wekospace/weko/documentation/paliers/SBRxxUU.jpg

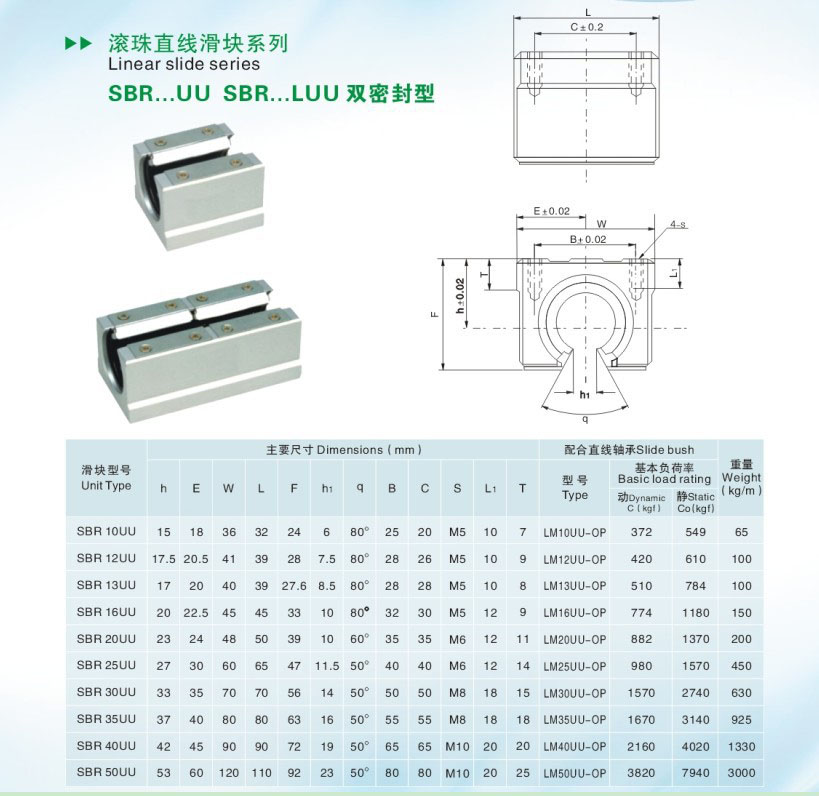
documentation/paliers/SBRxxUU.jpg
