wekospace/weko/documentation/moteurs/AluCNC - moteur Y - 57BYGH76-401A.jpg

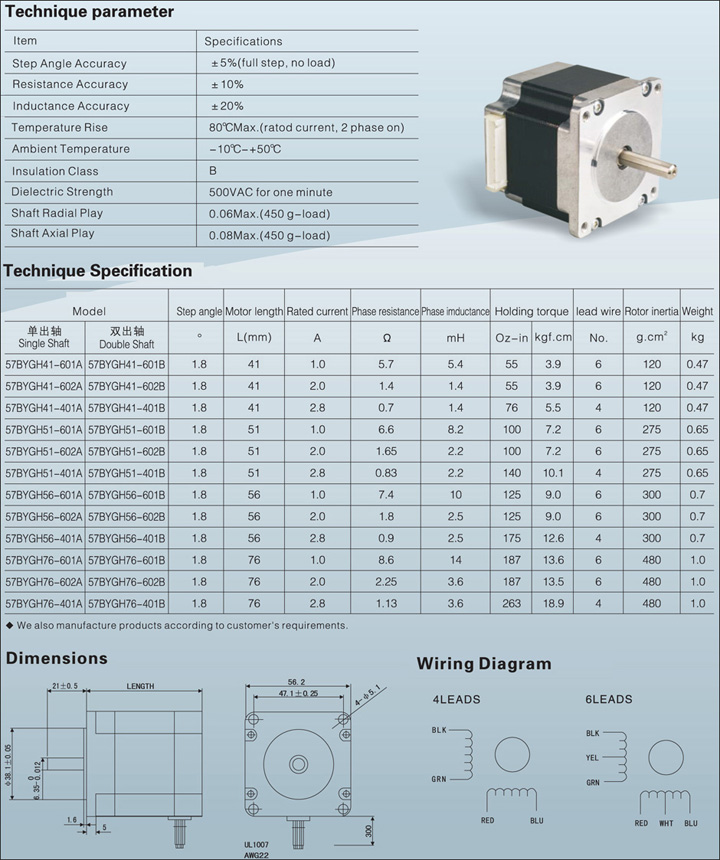
documentation/moteurs/AluCNC - moteur Y - 57BYGH76-401A.jpg
