wekospace/weko/documentation/paliers/SHFxx.jpg

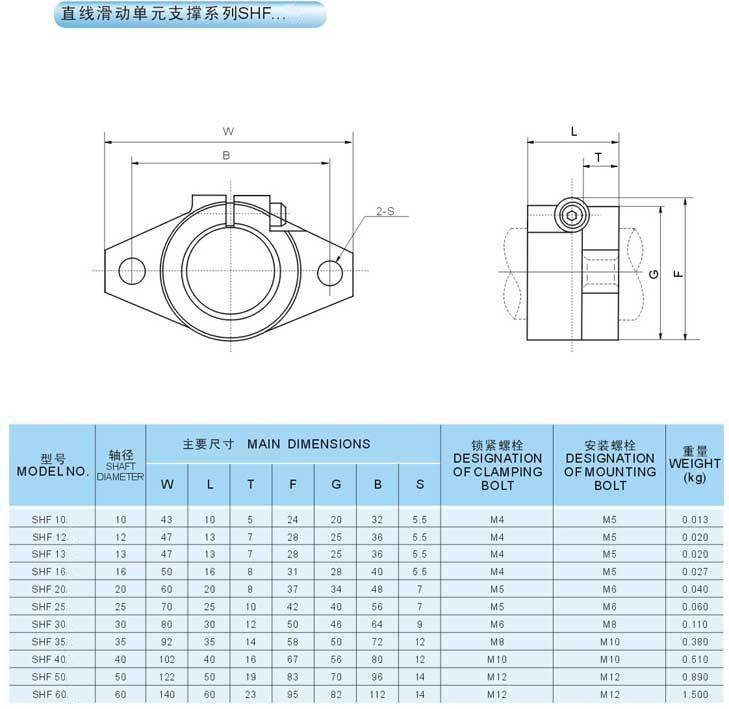
documentation/paliers/SHFxx.jpg
