wekospace/weko/Nomenclature.xls

N° | QTE | DESCRIPTION | OBSERVATION | DISTRIBUTEUR | CODE CDE DISTRIBUTEUR | UDV | QTE d'UDV | PRIX d'UDV HT | PRIX d'UDV TTC | PRIX HT | PRIX TTC | DISPONIBILITEE | TOTAL | ETAT | EMETTEUR | CEDRIC | CARLOS | ROMUALD
1 | 4 | Soutenu ferroviaire TBS20, 1000mm |  | MOTEDIS |  | 1 | 4 | 36.13 | 43.356 | 144.52 | 173.424 |  |  | reçu | CEDRIC | 395.4908
2 | 2 | Arbre de précision 20mm h6,trempé et rectifié, 400mm |  | MOTEDIS |  | 1 | 2 | 6.72 | 8.064 | 13.44 | 16.128
3 | 4 | Palier + douille a bille |  | MOTEDIS | SCE20UU | 1 | 4 | 7.48 | 8.976 | 29.92 | 35.904
4 | 4 | Support arbre Aluminium anodis | SH20 | MOTEDIS | SH20 | 1 | 4 | 3.53 | 4.236 | 14.12 | 16.944
5 | 2 | Profilé aluminium 45x90lourd B-Typ rainure 10 | 45x90lour x 1040mm, 4 x usinage M12 | MOTEDIS | 45x90lourd B-Typ | 1 | 2 | 27.32 | 32.784 | 54.64 | 65.568
6 | 2 | Profilé aluminium 40x80 B-Typ rainure 10 | 40x80 x 1040mm | MOTEDIS | 40x80 B-Typ | 1 | 2 | 16.61 | 19.932 | 33.22 | 39.864
7 | 30 | Tasseau lourd rainure 10 B-Typ | Ecrou tasseau, guidé, M6 | MOTEDIS |  | 1 | 30 | 0.2683 | 0.32196 | 8.049 | 9.6588
8 | 1 | livraison |  |  |  | 1 | 1 |  | 38 | 0 | 38
9 |  |  |  |  |  |  |  |  |  |  |  |  | 395.4908
 | 30 | Tasseau lourd rainure 8 B-Typ | Ecrou tasseau, guidé, M6 | MOTEDIS |  | 1 | 30 | 0.2683 | 0.32196 | 8.05 | 9.66 |  |  | reçu | ROMUALD |  |  | 70.508
 | 30 | Tasseau lourd rainure 10 B-Typ | Ecrou tasseau, guidé, M6 | MOTEDIS |  | 1 | 30 | 0.2683 | 0.32196 | 8.05 | 9.66
 | 2 | Profilé aluminium 30x60 B-Typ rainure 8 | 30x60 x 1040mm, 4 x usinage M8 | MOTEDIS | 30x60 B-Typ | 1 | 2 | 16.61 | 19.932 | 32.24 | 38.688
 | 1 | livraison |  |  |  | 1 | 1 |  | 12.5 | 0 | 12.5
 |  |  |  |  |  |  |  |  |  |  |  |  | 70.508
13 | 1 | ALU | 2 m2 | CEDRIC |  | 1 | 1 | 166.66 | 200 | 166.66 | 200 |  |  | reçu | CEDRIC | 200
14 | 1 | ALU | Ep20 L200 l100 | BLOCKENSTOCK |  | 1 | 1 | 24.999 | 30 | 24.999 | 30 |  |  |  | ND
15 |  |  |  |  |  |  |  |  |  |  |  |  | 230
16 | 2 | Vis à billes U-D1204-1000mm | Vis + Ecrou à billes Diamètre: 12mm Pas: 4mm/tour | EX MACHINA | EXM-VBU1204 | 1 | 2 |  | 100 |  | 200 | 10J |  | reçu | CARLOS |  | 476.03
17 | 1 | Vis à billes U-D1204-0300mm | Vis + Ecrou à billes Diamètre: 12mm Pas: 4mm/tour | EX MACHINA | EXM-VBU1204 | 1 | 1 |  | 79 |  | 79 | 10J
18 | 1 | Fourreau de demontage ecrou/vis 12mm |  | EX MACHINA | EXM-VABFD12 | 1 | 1 |  | 8.03 |  | 8.03
19 | 3 | Palier BK BF 10 | Ensemble de 2 Paliers pour vis à billes de 12mm | EX MACHINA | EXM-BKBF10 | 1 | 3 |  | 63 |  | 189
20 | 1 | livraison |  | EX MACHINA |  | 1 | 1 |  | 0 |  | 0
21 |  |  |  |  |  |  |  |  |  |  |  |  | 476.03
22 | 16 | TCHC M12X40 ACIER 8.8 Z.BLANC EF DIN 912 | Acier 8.8 Zingué Blanc Filetage Total Din 912 | FIXNVIS | TCHC12/040A8ZNEF | 1 | 20 | 0.4036 | 0.48 | 8.072 | 9.6 |  |  | reçu | CARLOS |  | 71.82 | 0
23 | 16 | SACHET DE 25 TCHC M10X45 ACIER 8.8 Z.BLANC PF DIN 912 | Acier 8.8 Zingué Blanc Filetage Total Din 912 | FIXNVIS | SACTCHC10/045A8ZNP | 25 | 1 | 6.9 | 8.28 | 6.9 | 8.28
24 | 12 | TCHC M5X16 ACIER 8.8 Z.BLANC EF DIN 912 | Acier 8.8 Zingué Blanc Filetage Total Din 912 | FIXNVIS | TCHC05/016A8ZNEF | 1 | 100 | 0.0492 | 0.06 | 4.92 | 6
25 | 76 | SACHET DE 25 TCHC M6X30 ACIER 8.8 Z.BLANC EF DIN 912 | Acier 8.8 Zingué Blanc Filetage Total Din 912 | FIXNVIS | SACTCHC06/030A8ZNE | 25 | 4 | 1.91 | 2.29 | 7.64 | 6.6 | P
26 | 8 | SACHET DE 25 TCHC M6X20 ACIER 8.8 Z.BLANC EF DIN 912 | Acier 8.8 Zingué Blanc Filetage Total Din 912 | FIXNVIS | SACTCHC06/020A8ZNE | 25 | 1 | 1.64 | 1.97 | 1.64 | 1.97
27 | 24 | TCHC M4X20 ACIER 8.8 Z.BLANC EF DIN 912 | Acier 8.8 Zingué Blanc Filetage Total Din 912 | FIXNVIS | TCHC04/020A8ZNEF | 1 | 50 | 0.0492 | 0.06 | 2.46 | 3
28 | 0 | TBHC EMBASE M6X30 Z.BLANC EF | Acier 8.8 Zingué Blanc Filetage Total Din 912 | FIXNVIS | TBHCEMB06/030ZN | 1 | 20 | 0.1588 | 0.19 | 3.176 | 3.8
29 | 20 | RONDELLE L 0 12 Z.BLANC NFE 25513 | Rondelle "L" Acier Zingué Blanc NFE 25513 | FIXNVIS | RONL12ZN | 1 | 20 | 0.0904 | 0.11 | 1.808 | 2.2
30 | 20 | RONDELLE L 0 10 Z.BLANC NFE 25513 | Rondelle "L" Acier Zingué Blanc NFE 25513 | FIXNVIS | RONL10ZN | 1 | 50 | 0.0524 | 0.06 | 2.62 | 3
31 | 50 | RONDELLE L 0 6 Z.BLANC NFE 25513 | Rondelle "L" Acier Zingué Blanc NFE 25513 | FIXNVIS | RONL06ZN | 1 | 50 | 0.0152 | 0.02 | 0.76 | 1
32 | 56 | TCHC M5X18 ACIER 8.8 Z.BLANC EF DIN 912 | Acier 8.8 Zingué Blanc Filetage Total Din 912 | FIXNVIS | TCHC05/018A8ZNEF | 1 | 100 | 0.0247 | 0.05 | 2.47 | 3.36 | P
33 | 28 | TBHC EMBASE M6X16 Z.BLANC | Acier 8.8 Zingué Blanc Filetage Total Din 912 | FIXNVIS | TBHCEMB06/016ZN | 1 | 30 | 0.134 | 0.16 | 4.02 | 4.8
 |  |  |  |  |  |  |  |  |  |  |  |  | 53.61
 | 100 | RONDELLE L 0 8 Z.BLANC NFE 25513 | Rondelle "L" Acier Zingué Blanc NFE 25513 | FIXNVIS | RONL08ZN | 1 | 100 | 0.024 | 0.03 | 2.4 | 3.22
 | 100 | RONDELLE W 0 6 Z.BLANC DIN 127B | Rondelle "W" Acier Zingué Blanc DIN 127B | FIXNVIS | RONW06ZNDIN127B | 1 | 100 | 0.024 | 0.03 | 2.4 | 2.59
 | 10 | TCHC M6X65 ACIER 8.8 Z.BLANC PF DIN 912 | Acier 8.8 Zingué Blanc Filetage Total Din 912 | FIXNVIS | TCHC06/065A8ZNPF | 1 | 10 | 0.2 | 0.25 | 2 | 2.54
 | 20 | TCHC M8X40 ACIER 8.8 Z.BLANC PF DIN 912 | Acier 8.8 Zingué Blanc Filetage Total Din 912 | FIXNVIS | TCHC08/040A8ZNPF | 1 | 20 | 0.184 | 0.23 | 3.68 | 4.6
 | 10 | TCHC M12X45 ACIER 8.8 Z.BLANC EF DIN 912 | Acier 8.8 Zingué Blanc Filetage Total Din 912 | FIXNVIS | TCHC12/045A8ZNEF | 1 | 10 | 0.424 | 0.53 | 4.24 | 5.26
34 |  |  |  |  |  |  |  |  |  |  |  |  | 18.21
35 | 3 | Moteur 23HS30-2804S | NEMA 23 18,9 kg.cm | GOTRONIC | 31120 | 1 | 3 |  | 37.7 |  | 113.1 |  |  |  | ROMUALD |  |  | 113.1
36 | 1 | 24V 10A 240W Switching Power Supply for LED Strip light |  | BANG GOOD | SKU032947 | 1 | 1 |  | 17.11 |  | 17.11 |  |  | reçu | ROMUALD |  |  | 17.11
37 | 3 | TB6560 3A CNC Router 1 Axis Driver Board Stepper Motor Drivers |  | BANG GOOD | SKU124340 | 1 | 3 |  | 5.7 |  | 17.1 |  |  | reçu | ROMUALD |  |  | 17.1
38 | 8 | Palier + douille a bille ouvert |  | BANG GOOD | SBR20UU | 1 | 8 |  | 4.26 |  | 34.08 |  |  | reçu | ROMUALD |  |  | 34.08
39 | 3 | Accouplement | 6,35 / 8mm | EBAY |  | 1 | 3 |  | 4.11 |  | 12.33 |  |  | reçu | ROMUALD |  |  | 12.33
40 | 4 | Fraises |  | OTELO |  | 1 | 4 |  | 15 |  | 60 |  |  | reçu | CEDRIC | 60
41 |  |  |  |  |  |  |  |  |  |  |  |  | 253.72
 |  |  |  |  |  |  |  |  |  |  |  | TOTAL | 1497.5688 |  |  | 655.4908 | 547.85 | 264.228 | 1467.5688 | 30
