wekospace/weko/accessoires/aspiration/support_poils.dxf

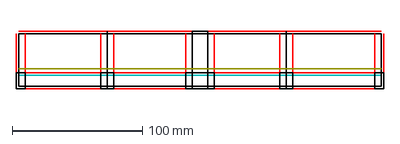
[picture p4: CAD file, 2015-03-06]
accessoires/aspiration/support_poils.dxf
282.8 x 44.0 mm
