wekospace/weko/cnc.fcstd

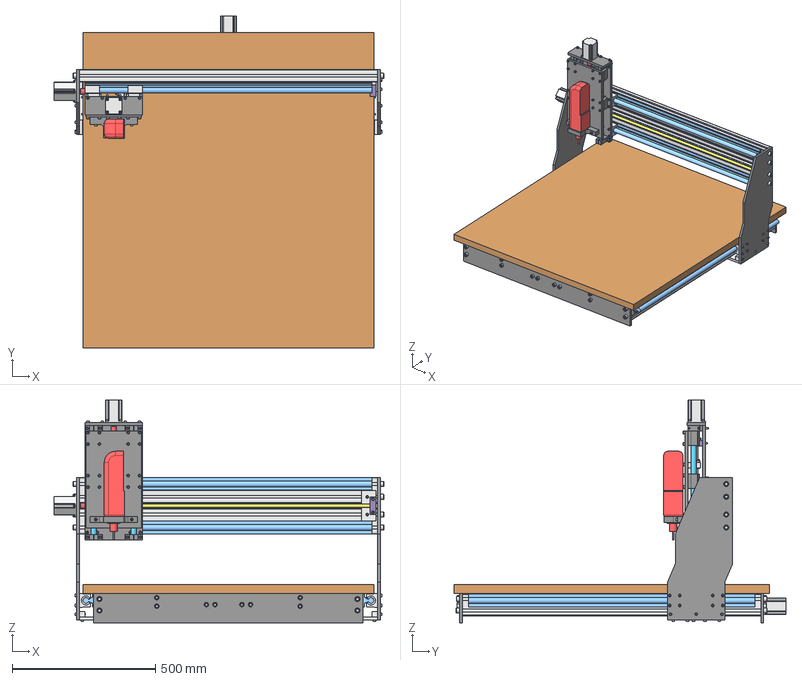
[picture p5: CAD file, 2015-04-27]
cnc.fcstd
1150.0 x 1158.0 x 776.5 mm
SBR20-RAIL L1000 A
SBR20-RAIL L1000 B
PROFILE 40x80 L1040 B
PROFILE 40x80 L1040 A
PROFILE 30x60 L1040 A
PROFILE 30x60 L1040 B
PROFILE 30x60 L1040 C
PROFILE 30x60 L1040 D
VIS_BILLE_1000 Y
BF10 Y
BK10 Y
BAGUE Y
ECROU_KM0 Y
ACCOUPLEMENT Y
ALU_SUP_PAL Y A
ALU_SUP_PAL Y B
NEMA_23 Y
ALU CHASSIS B
ALU CHASSIS A
MARTYR
SBR20UU Y 4
SBR20UU Y 3
SBR20UU Y 2
SBR20UU Y 1
SBR20-RAIL L1000 C
SBR20-RAIL L1000 D
VIS_BILLE_1001
BK10
BF10
ALU_Y_SUP_PAL A
ALU_Y_SUP_PAL B
BAGUE X
ECROU_KM0 X
ACCOUPLEMENT X
PROFILE 45x90 L1040 A
PROFILE 45x90 L1040 B
ECROU_RM1204 Y
ALU_CURSEUR_Y
ALU X C
ALU Y A
EQUERRE Y A
ALU Y C
EQUERRE Y B
ALU Y B
NEMA_23 X
SBR20UU
SBR20UU001
SBR20UU002
SBR20UU003
SH021
SH022
SH023
ARBRE D20 L400 A
ARBRE D20 L400 B
ECROU_RM1204 X
ACCOUPLEMENT Z
ECROU_KM0 Z
BAGUE Z
BK10 Z
BF10 Z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
