wekospace/weko/pieces/facade_av.dxf

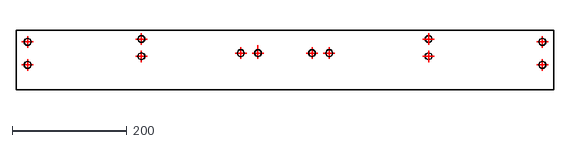
[picture p6: CAD file, 2015-04-27]
pieces/facade_av.dxf
936.0 x 103.0
