wekospace/weko/usinage/curseur_Y.dxf

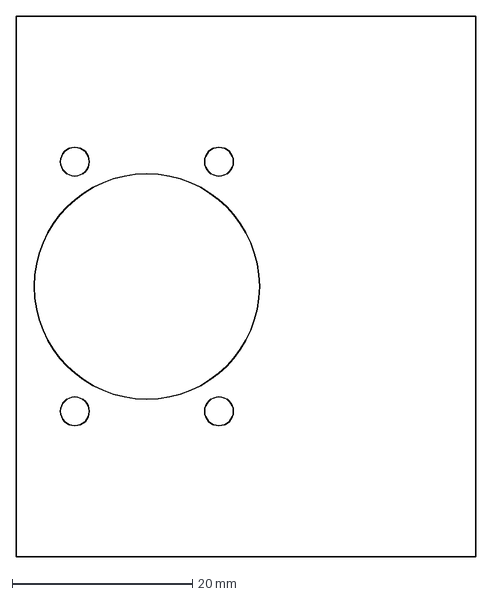
[picture p7: CAD file, 2015-04-27]
usinage/curseur_Y.dxf
51.0 x 60.0 mm
