wekospace/weko/accessoires/aspiration/support_aimants.dxf

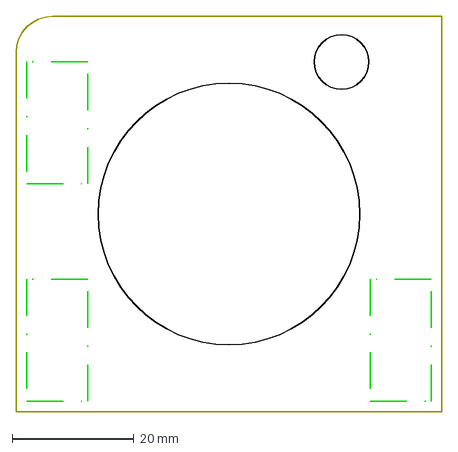
[picture p8: CAD file, 2015-03-06]
accessoires/aspiration/support_aimants.dxf
70.0 x 65.0 mm
