wekospace/weko/pieces/equerre_montant.dxf

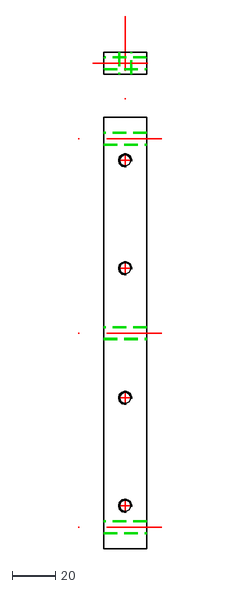
[picture p9: CAD file, 2015-04-27]
pieces/equerre_montant.dxf
38.5 x 246.9
