wekospace/weko/usinage/curseur_X.dxf

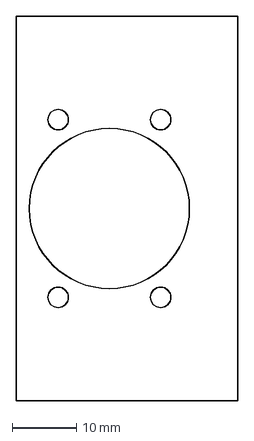
[picture p10: CAD file, 2015-04-27]
usinage/curseur_X.dxf
34.5 x 60.0 mm
