wekospace/weko/weko_cnc.dxf

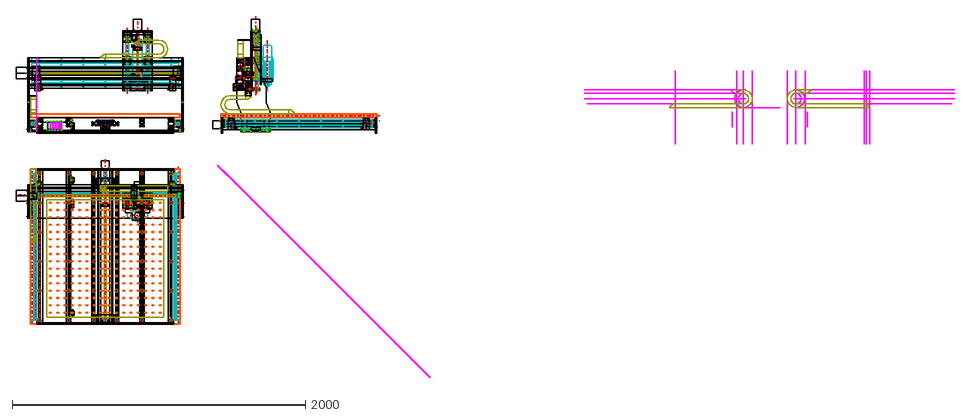
[picture p11: CAD file, 2015-03-04]
weko_cnc.dxf
6400.7 x 2466.1
