wekospace/weko/accessoires/aspiration/support_aspirateur.dxf

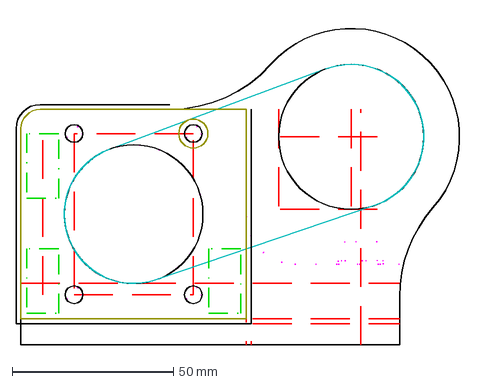
[picture p12: CAD file, 2015-03-06]
accessoires/aspiration/support_aspirateur.dxf
141.5 x 101.9 mm
