wekospace/weko/pieces/supports_switch_Y.dxf

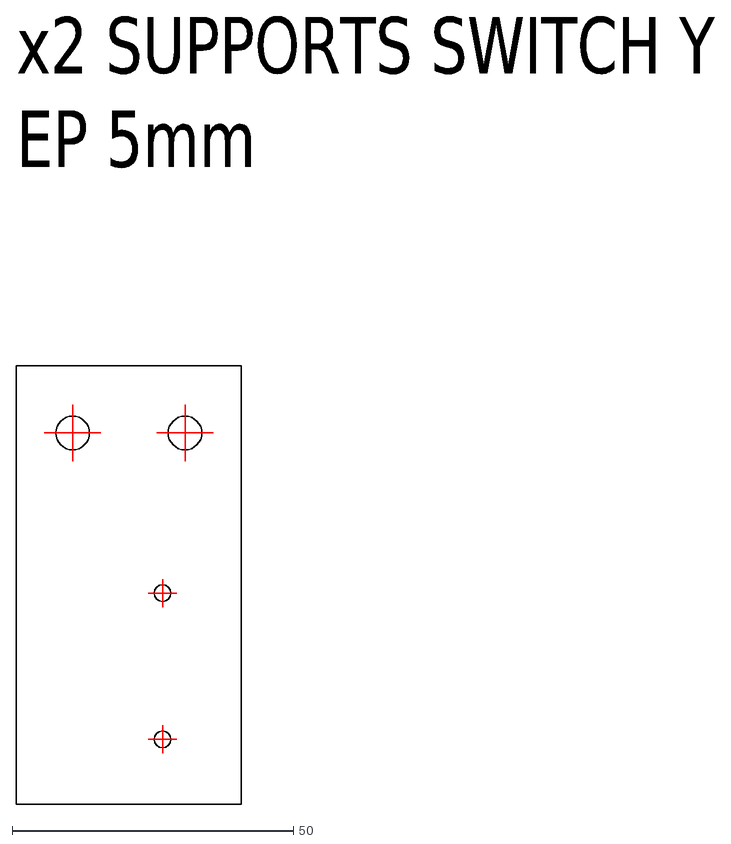
[picture p13: CAD file, 2015-04-27]
pieces/supports_switch_Y.dxf
x2\~SUPPORTS\~SWITCH\~Y EP\~5mm
