wekospace/weko/usinage/profilé_X_percages.dxf

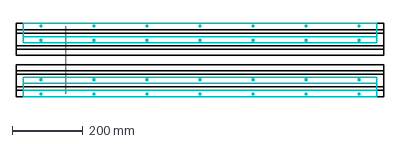
[picture p14: CAD file, 2015-04-27]
usinage/profilé_X_percages.dxf
1040.0 x 207.0 mm
