wekospace/weko/accessoires/aspiration/support_aspirateur_verso.dxf

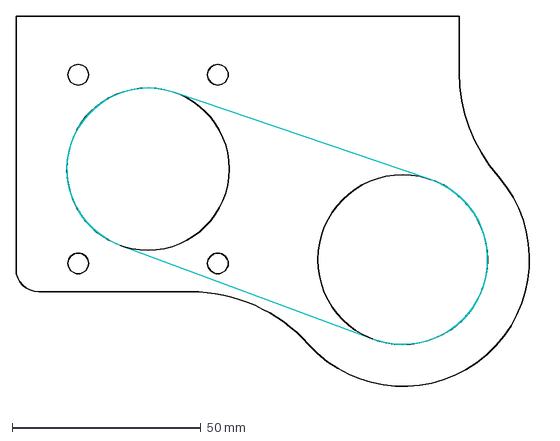
[picture p15: CAD file, 2015-03-05]
accessoires/aspiration/support_aspirateur_verso.dxf
140.0 x 101.9 mm
