wekospace/weko/pieces/plaque_Z_mobile.dxf

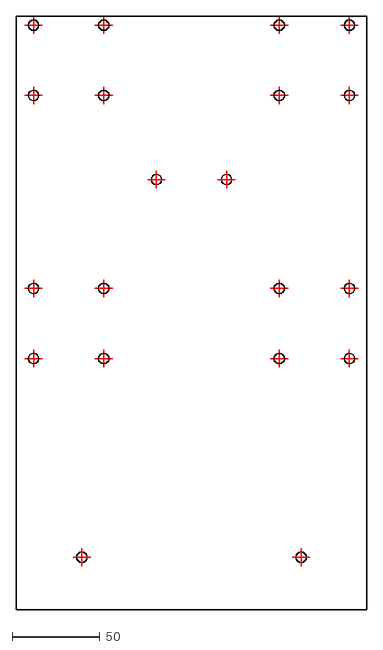
[picture p16: CAD file, 2015-04-27]
pieces/plaque_Z_mobile.dxf
200.0 x 338.0
