wekospace/weko/usinage/curseur_percage.dxf

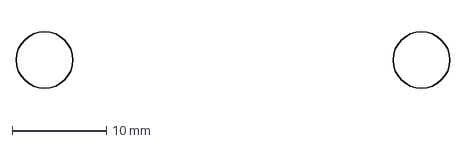
[picture p17: CAD file, 2015-04-27]
usinage/curseur_percage.dxf
46.0 x 6.00 mm
