wekospace/weko/pieces/facade_ar.dxf

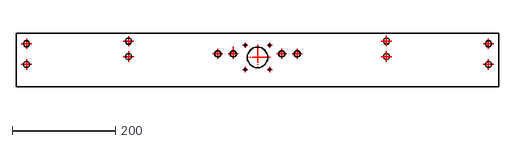
[picture p18: CAD file, 2015-04-27]
pieces/facade_ar.dxf
936.0 x 103.0
