wekospace/weko/usinage/Z_reprise_percage.dxf

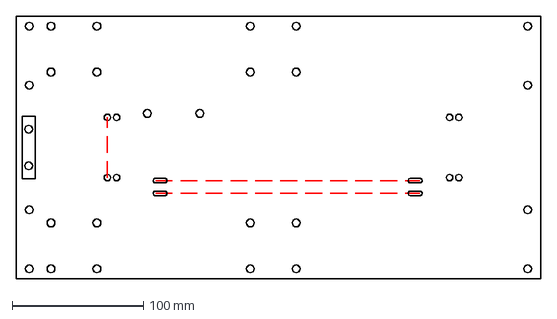
[picture p19: CAD file, 2015-04-27]
usinage/Z_reprise_percage.dxf
400.0 x 200.0 mm
