wekospace/weko/pieces/montant.dxf

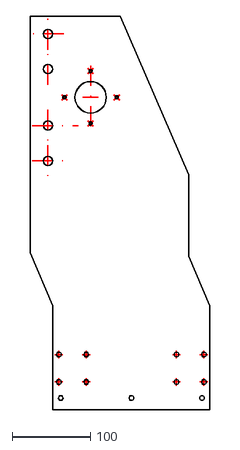
[picture p20: CAD file, 2015-04-27]
pieces/montant.dxf
229.0 x 502.0
