wekospace/weko/usinage/équerre_montant.dxf

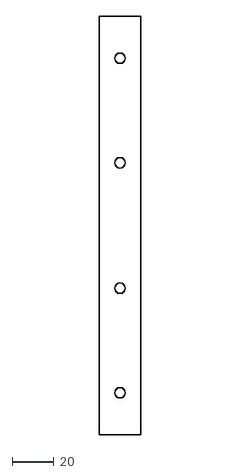
[picture p21: CAD file, 2015-04-27]
usinage/équerre_montant.dxf
20.0 x 200.0
