wekospace/weko/pieces/plaque_reprise_switch_Y.dxf

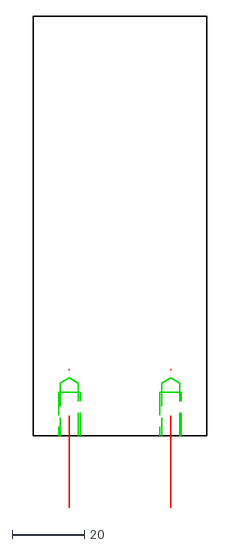
[picture p22: CAD file, 2015-04-27]
pieces/plaque_reprise_switch_Y.dxf
48.0 x 136.0
