wekospace/weko/usinage/support_palierYX.dxf

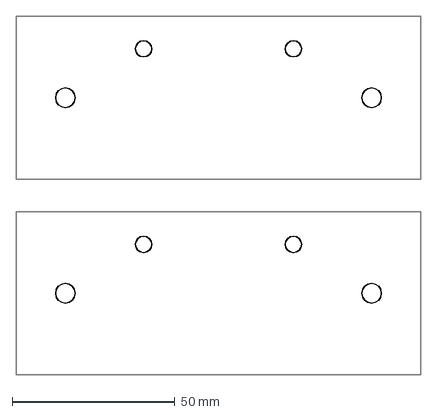
[picture p23: CAD file, 2015-04-27]
usinage/support_palierYX.dxf
124.0 x 110.0 mm
