wekospace/weko/pieces/butee_switchs_Y.dxf

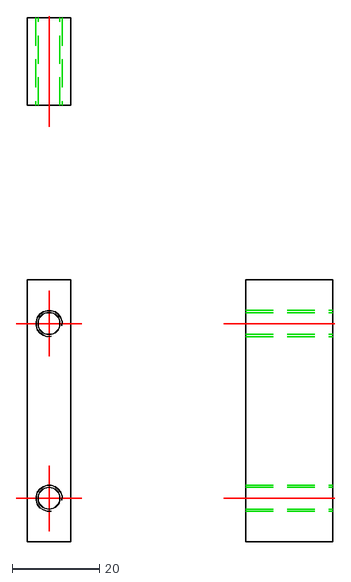
[picture p24: CAD file, 2015-04-27]
pieces/butee_switchs_Y.dxf
72.9 x 120.4
