wekospace/weko/pieces/plaque_Z_fixe.dxf

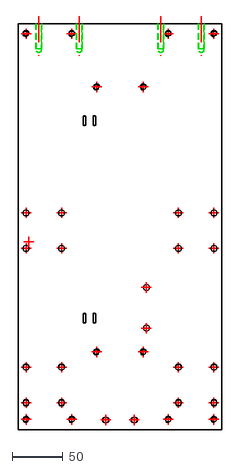
[picture p25: CAD file, 2015-04-27]
pieces/plaque_Z_fixe.dxf
200.0 x 407.0
