wekospace/weko/usinage/support_palierXY.dxf

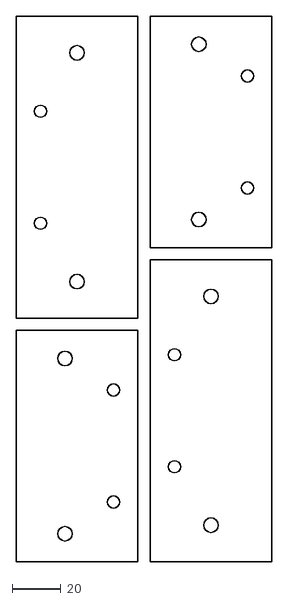
[picture p26: CAD file, 2015-04-27]
usinage/support_palierXY.dxf
105.0 x 224.0
