wekospace/weko/pieces/divers.dxf

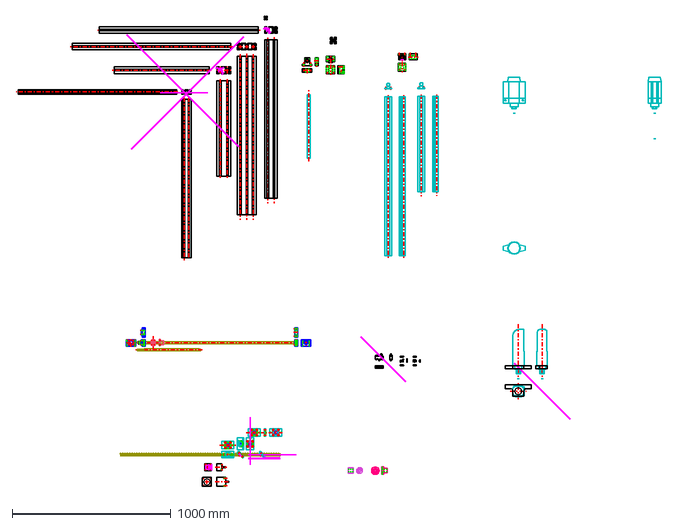
[picture p27: CAD file, 2015-04-27]
pieces/divers.dxf
4062.4 x 2960.4 mm
