wekospace/weko/pieces/plaque_accouplement_montant.dxf

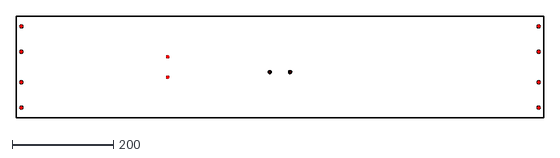
[picture p28: CAD file, 2015-04-27]
pieces/plaque_accouplement_montant.dxf
1040.0 x 200.0
