wekospace/weko/pieces/supports_moteur_Z.dxf

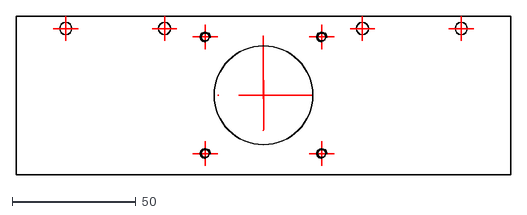
[picture p29: CAD file, 2015-04-27]
pieces/supports_moteur_Z.dxf
200.0 x 64.2
