wekospace/weko/pieces/curseurs.dxf

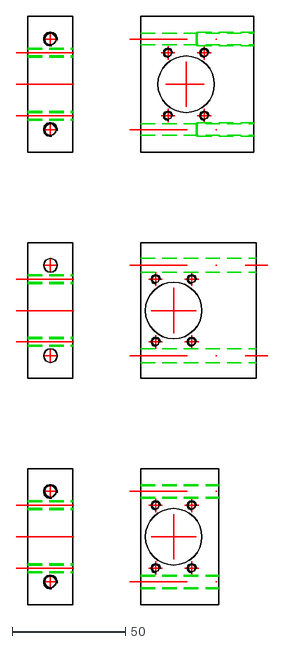
[picture p30: CAD file, 2015-04-27]
pieces/curseurs.dxf
111.0 x 260.0
