wekospace/weko/pieces/supports_palier_X_Y.dxf

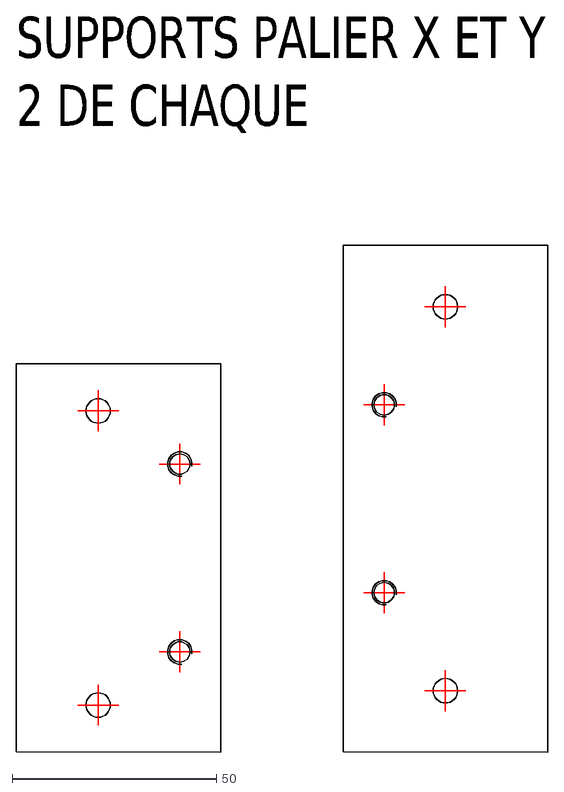
[picture p31: CAD file, 2015-04-27]
pieces/supports_palier_X_Y.dxf
SUPPORTS\~PALIER\~X\~ET\~Y 2\~DE\~CHAQUE
