wekospace/weko/pieces/supports_switch_X.dxf

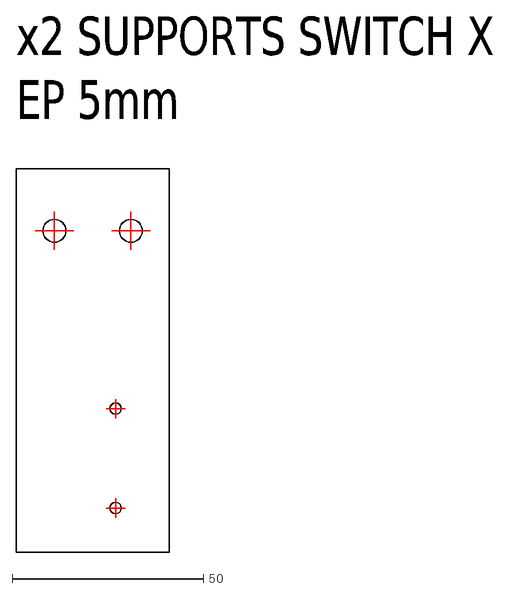
[picture p32: CAD file, 2015-04-27]
pieces/supports_switch_X.dxf
x2\~SUPPORTS\~SWITCH\~X EP\~5mm
