wekospace/weko/(list of files, cad)

Other CAD files:
usinage/Montant_avec_moteur_1-2.dxf
