wekospace/weko/electronique/weko.sch

## EAGLE design electronique/weko.sch (2015-10-14)

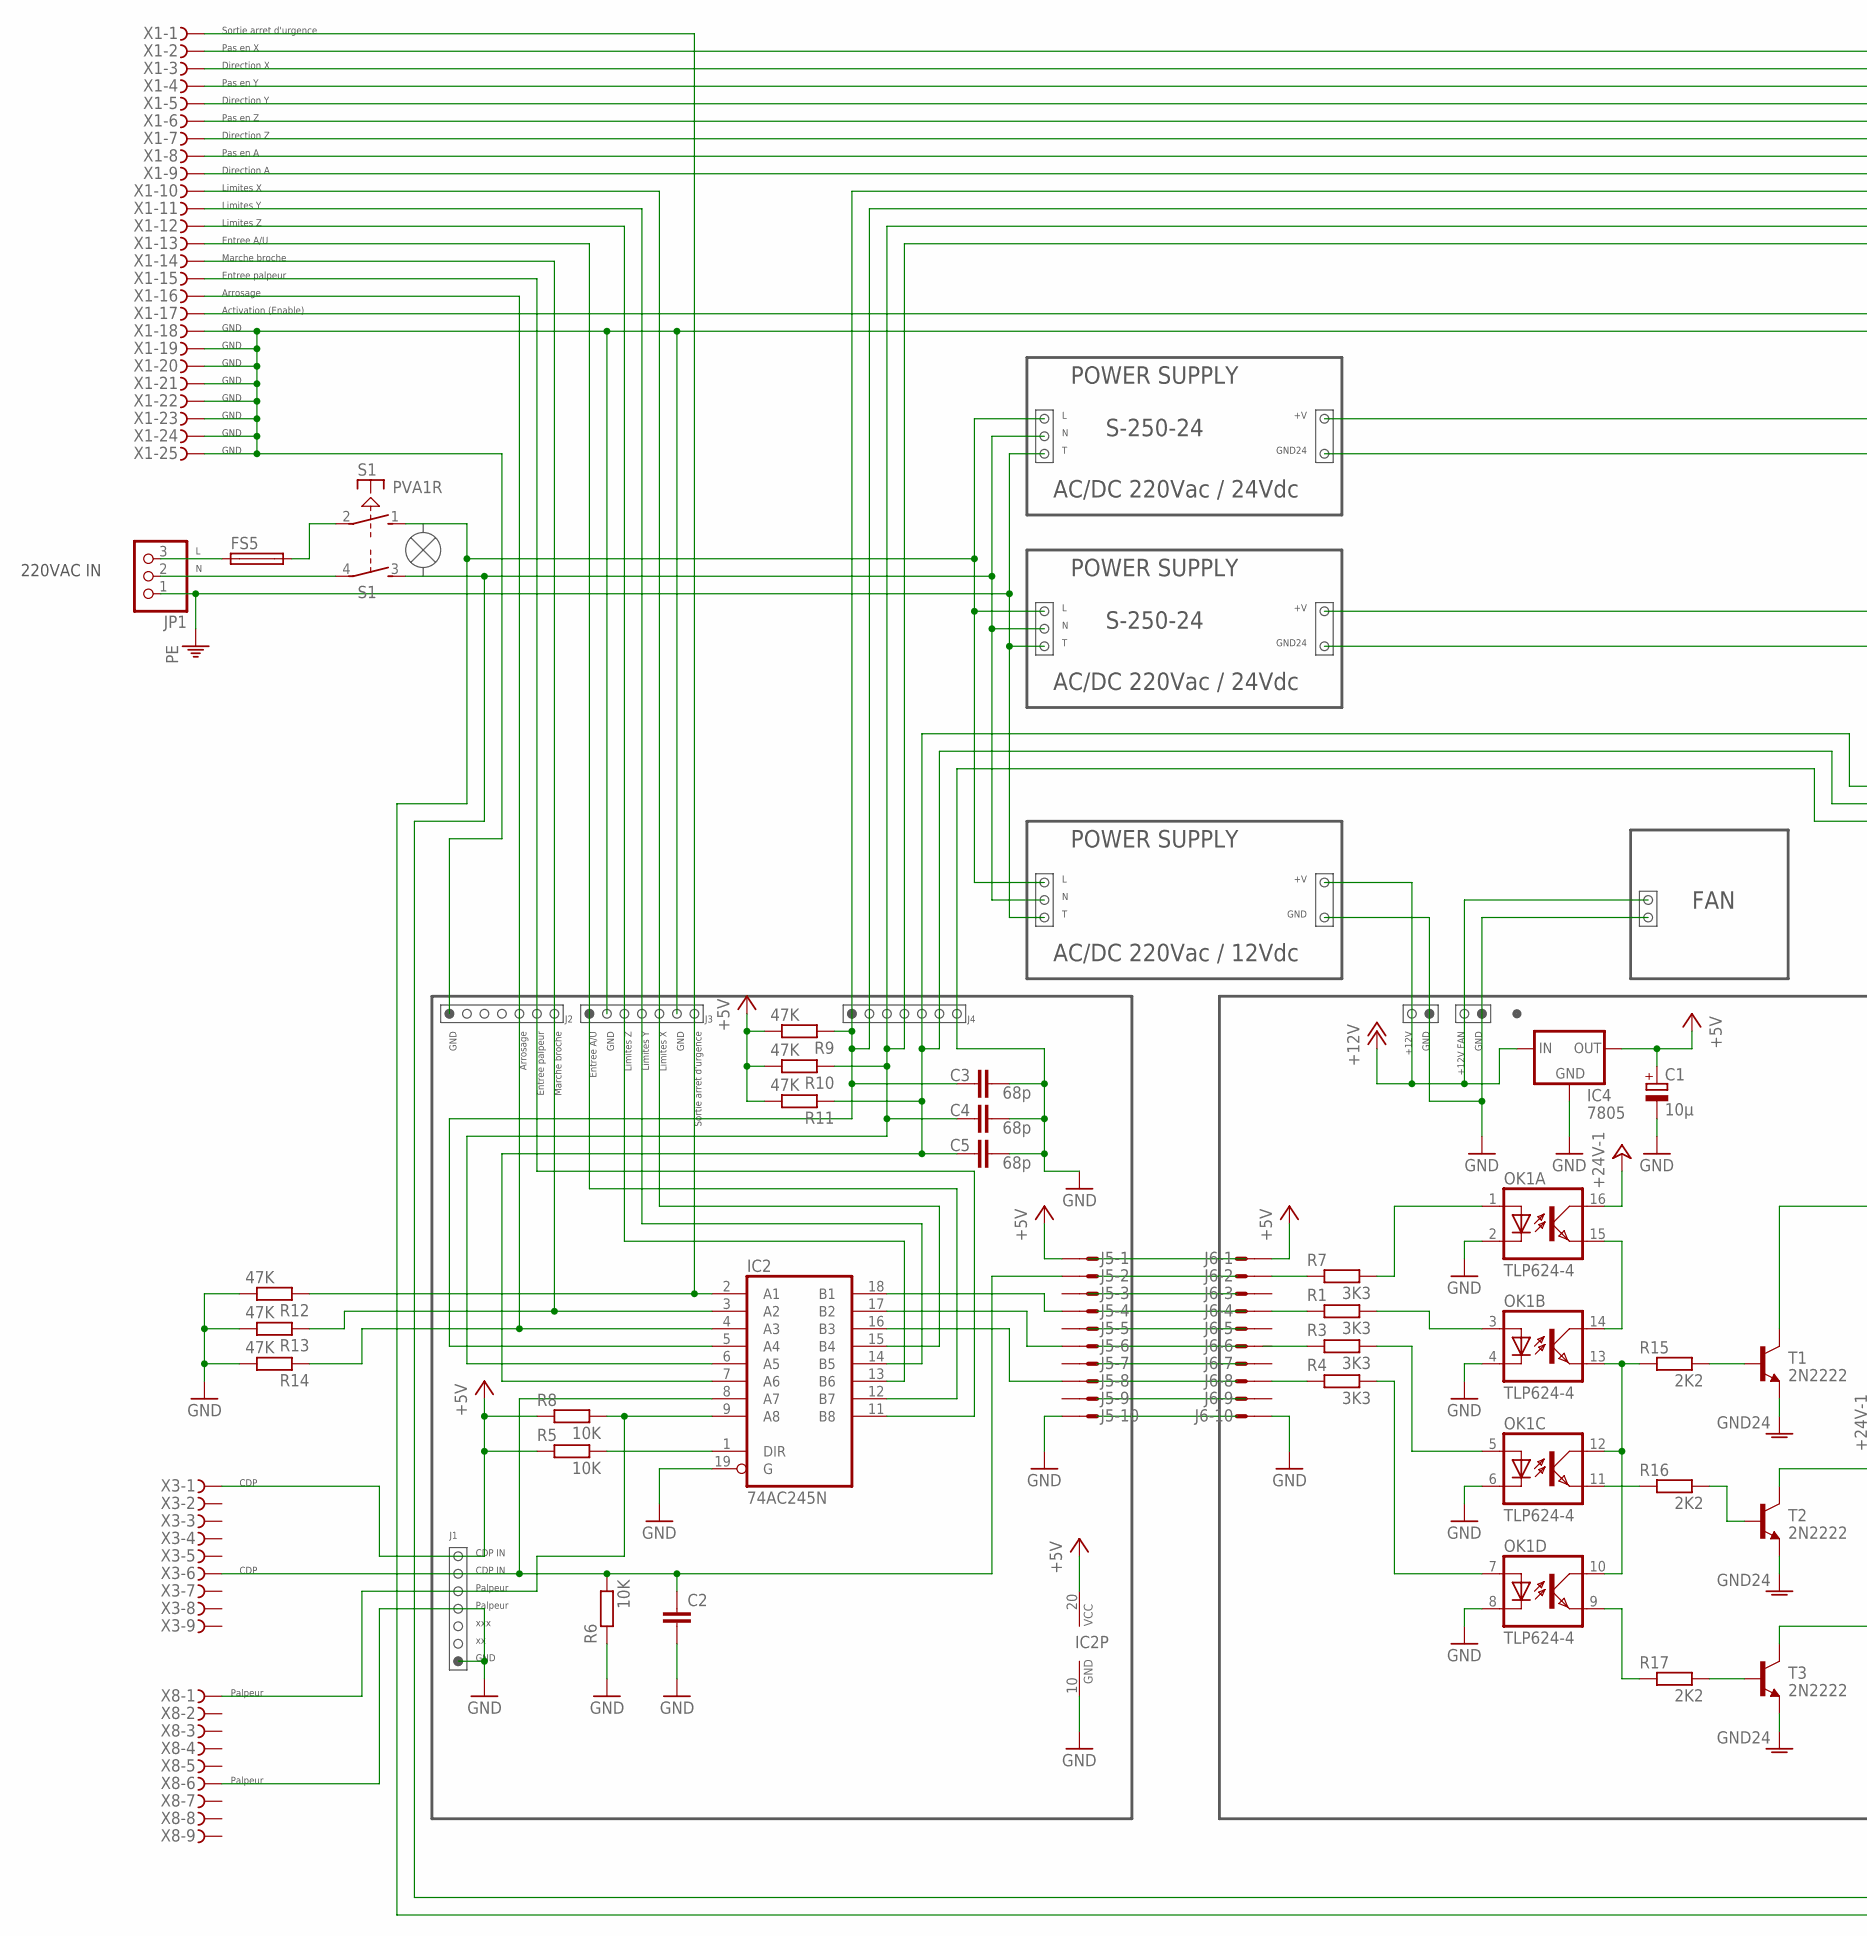
[picture p33: schematic weko.sch, part in row 1, column 1]

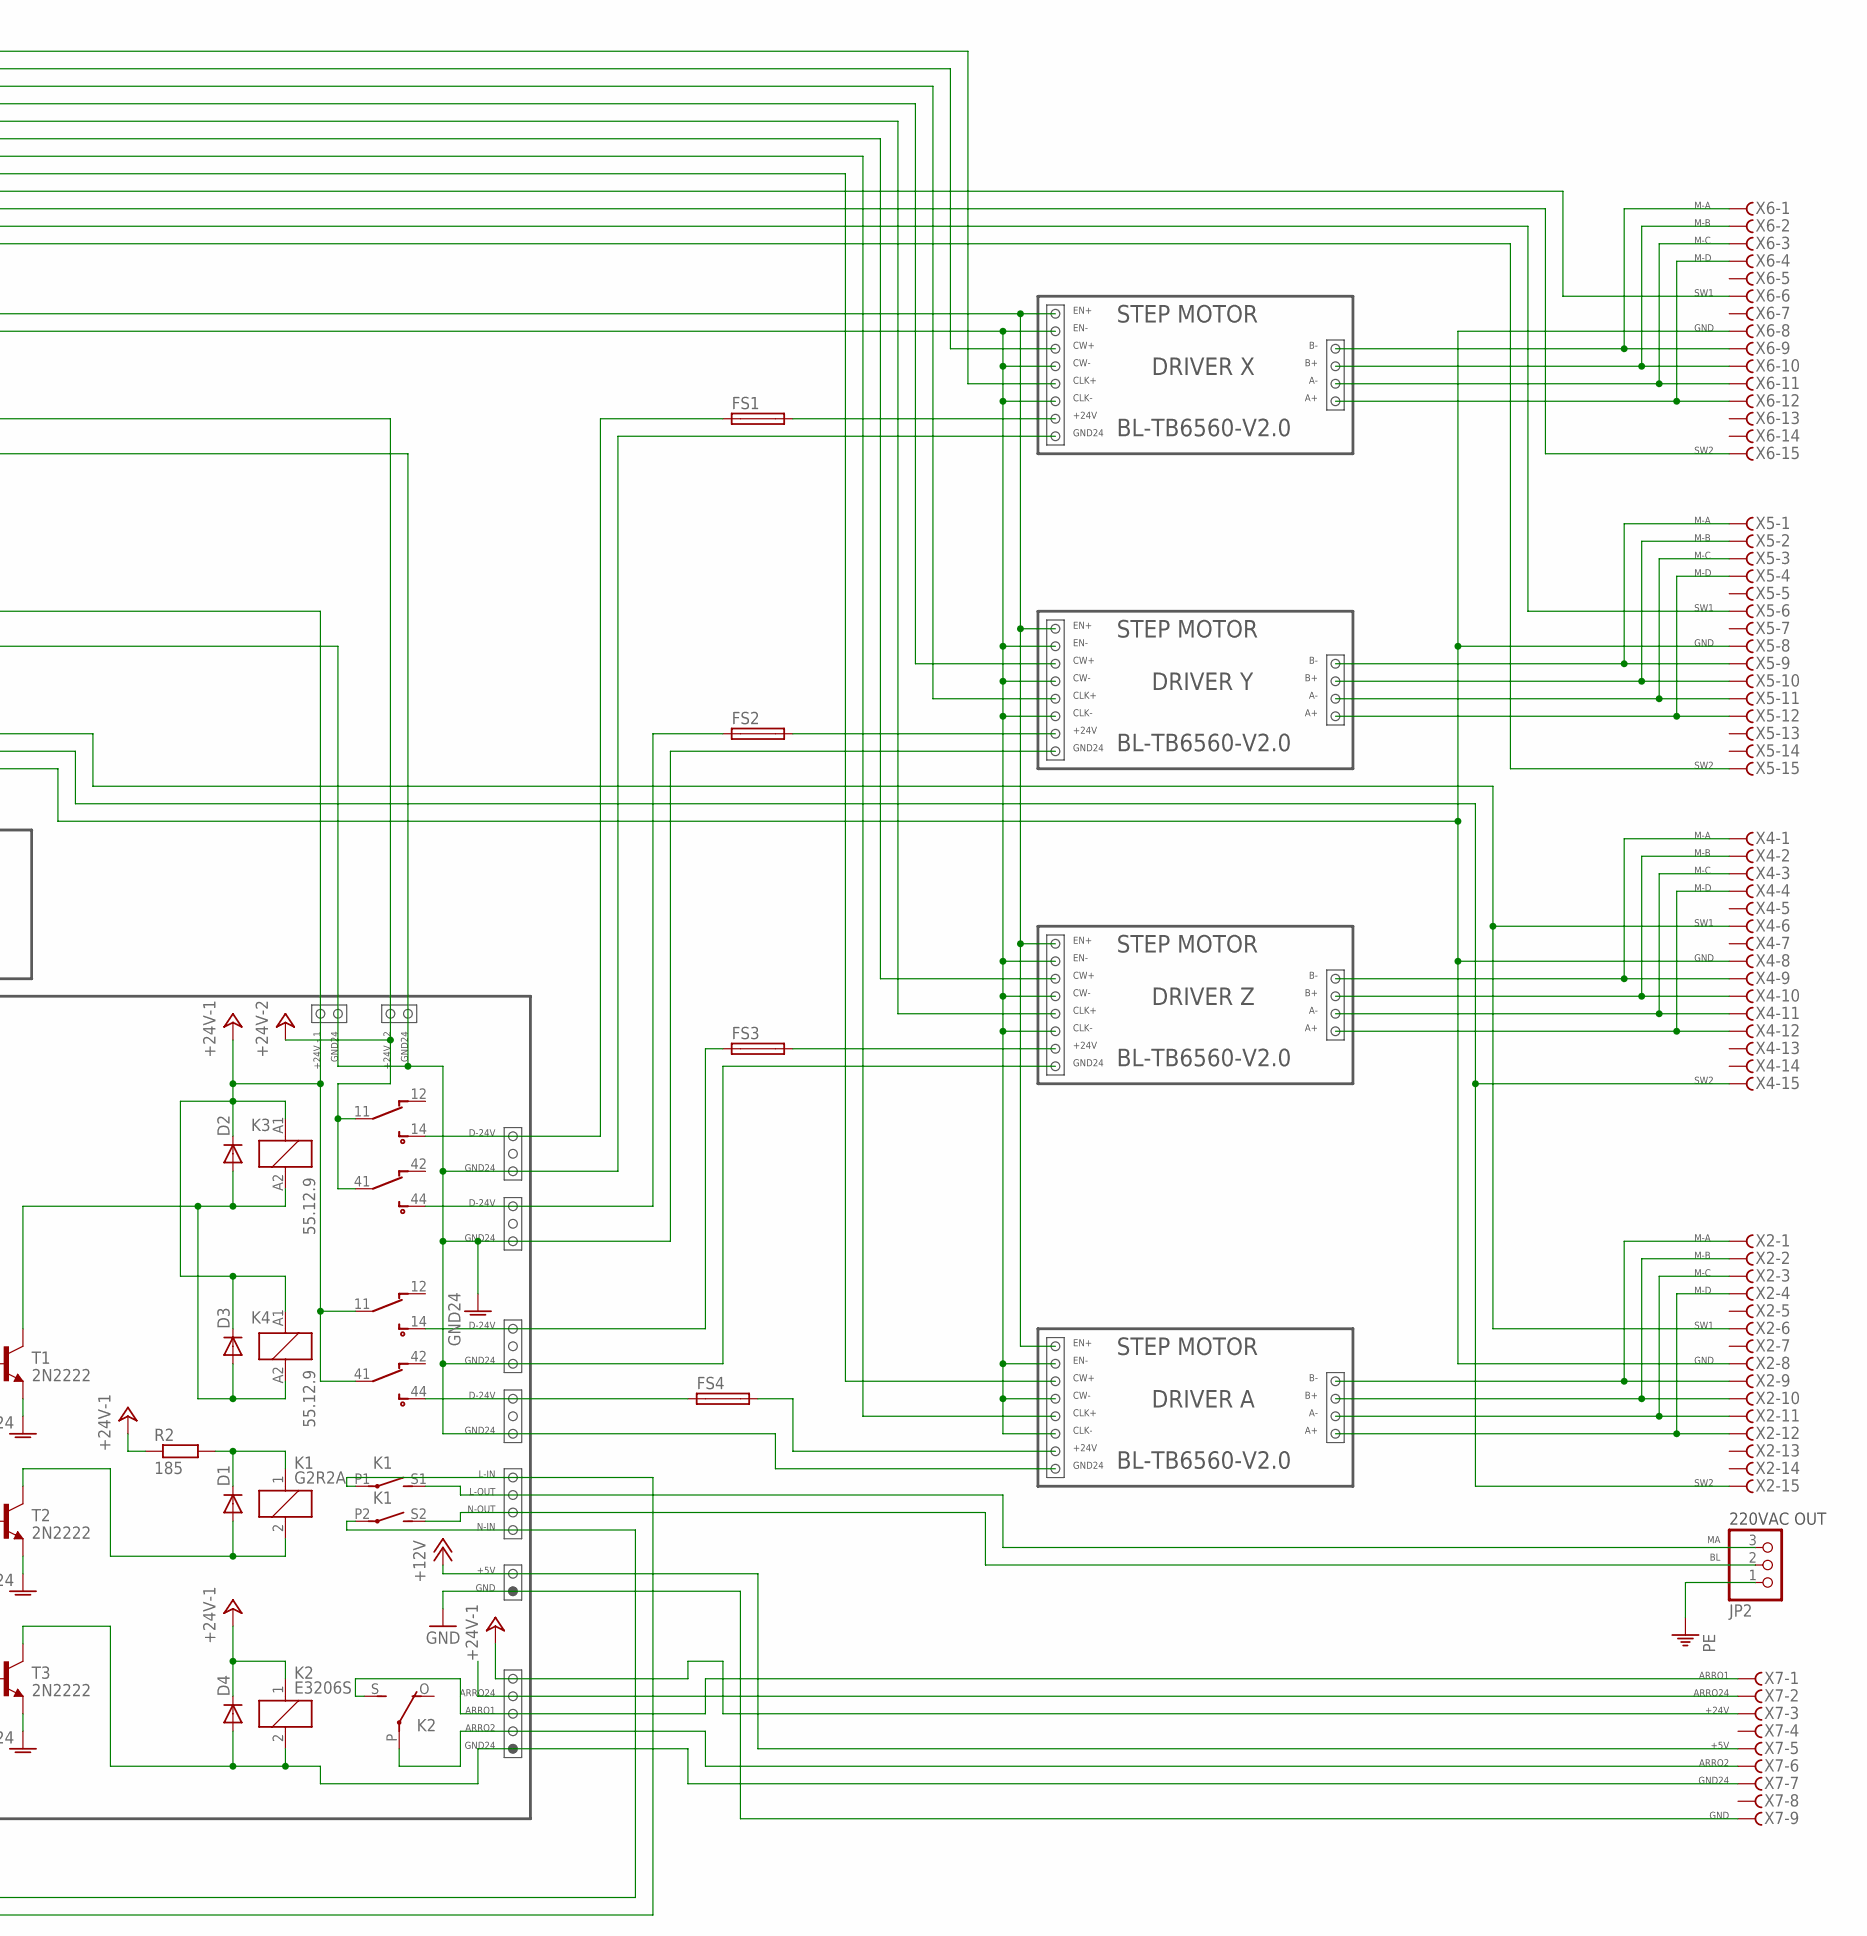
[picture p34: schematic weko.sch, part in row 1, column 2]

Parts:
C1: 10µ; E2-4
C2: C-EU050-030X075; C050-030X075
C3, C4, C5: 68p; C050-030X075
D1, D2, D3, D4: 1N4148DO35-10; DO35-10
FS1, FS2, FS3, FS4, FS5: KS10H
IC2: 74AC245N; DIL20
IC4: 7805; 78MXXS
J5, J6: 10HS; 10H
JP1, JP2: PINHD-1X03_2.00; 1X03M
K1: G2R2A
K2: E3206S
K3, K4: 55.12.9; 55.12
OK1: TLP624-4; MINI-FLAT-16
R1, R3, R4, R7: 3K3; 0411/12
R2: 185; 0411/12
R5, R6, R8: 10K; 0411/12
R9, R10, R11, R12, R13, R14: 47K; 0411/12
R15, R16, R17: 2K2; 0411/12
S1: PVA1R
T1, T2, T3: 2N2222; TO18
X1: F25VBS; F25VB
X2, X4, X5, X6: F15VBS; F15VB
X3, X7, X8: F09VBS; F09VB

Connections:
+5V: C1.+, IC2.20 (VCC), IC4.OUT, J5.1, J6.1, R5.2, R8.2, R9.1, R10.1, R11.1, X3.1
+12V: IC4.IN, X7.5
+24V: D2.C, D3.C, D4.C, K2.1, K3.11 (9), K3.41 (12), K3.A1, K4.11 (9), K4.41 (12), K4.A1, OK1.16 (COL), R2.1, X7.3
AGND: T1.1 (E), T2.1 (E), T3.1 (E)
GND: C1.-, C2.2, C3.2, C4.2, C5.2, IC2.10 (GND), IC2.19 (G), IC4.GND, J5.10, J6.10, OK1.2 (C), OK1.4 (C), OK1.6 (C), OK1.8 (C), R6.2, R12.1, R13.1, R14.1, X2.8, X4.8, X5.8, X6.8, X7.9, X8.6
unnamed: OK1.5 (A), R3.1
unnamed: OK1.3 (A), R1.1
unnamed: K1.P2, S1.3 (S)
unnamed: OK1.9 (EMIT), R17.2
unnamed: FS5.1, JP1.3
unnamed: IC2.18 (B1), J5.4
unnamed: J6.8, R4.2
unnamed: IC2.1 (DIR), R5.1
unnamed: D1.C, K1.1, R2.2
unnamed: K2.P, X7.6
unnamed: OK1.10 (COL), OK1.12 (COL), OK1.13 (EMIT), R15.2
unnamed: OK1.14 (COL), OK1.15 (EMIT)
unnamed: C2.1, IC2.8 (A7), J5.2, R6.1, X3.6
unnamed: K2.S, X7.1
unnamed: OK1.1 (A), R7.1
unnamed: IC2.16 (B3), J5.8
unnamed: OK1.7 (A), R4.1
unnamed: IC2.2 (A1), R12.2, X1.1
unnamed: IC2.15 (B4), X1.10
unnamed: IC2.14 (B5), X1.11
unnamed: IC2.13 (B6), X1.12
unnamed: IC2.12 (B7), X1.13
unnamed: IC2.3 (A2), R13.2, X1.14
unnamed: IC2.11 (B8), X1.15
unnamed: IC2.4 (A3), R14.2, X1.16
unnamed: K1.P1, S1.1 (S)
unnamed: C3.1, IC2.5 (A4), R9.2, X6.6, X6.15
unnamed: IC2.9 (A8), R8.1, X8.1
unnamed: C4.1, IC2.6 (A5), R10.2, X5.6, X5.15
unnamed: J6.2, R7.2
unnamed: C5.1, IC2.7 (A6), R11.2, X2.6, X2.15, X4.6, X4.15
unnamed: IC2.17 (B2), J5.6
unnamed: J6.4, R1.2
unnamed: JP1.2, S1.4
unnamed: JP2.3, K1.S1 (S)
unnamed: JP2.2, K1.S2 (S)
unnamed: X2.1, X2.9
unnamed: X2.2, X2.10
unnamed: X2.3, X2.11
unnamed: X2.4, X2.12
unnamed: X4.1, X4.9
unnamed: X4.2, X4.10
unnamed: X4.3, X4.11
unnamed: X4.4, X4.12
unnamed: X5.1, X5.9
unnamed: X5.2, X5.10
unnamed: FS5.2, S1.2
unnamed: X5.3, X5.11
unnamed: X5.4, X5.12
unnamed: R17.1, T3.2 (B)
unnamed: D4.A, K2.2, T3.3 (C), X7.7
unnamed: D2.A, D3.A, K3.A2, K4.A2, T1.3 (C)
unnamed: X6.1, X6.9
unnamed: R15.1, T1.2 (B)
unnamed: OK1.11 (EMIT), R16.2
unnamed: R16.1, T2.2 (B)
unnamed: D1.A, K1.2, T2.3 (C)
unnamed: X6.2, X6.10
unnamed: X6.3, X6.11
unnamed: X6.4, X6.12
unnamed: FS1.1, K3.14 (5)
unnamed: FS2.1, K3.44 (8)
unnamed: FS3.1, K4.14 (5)
unnamed: FS4.1, K4.44 (8)
unnamed: X1.18, X1.19, X1.20, X1.21, X1.22, X1.23, X1.24, X1.25
PE: JP1.1, JP2.1

Notes on the sheet:
220VAC IN
220VAC OUT
D-24V
GND24
POWER SUPPLY
S-250-24
AC/DC 220Vac / 24Vdc
STEP MOTOR
DRIVER A
BL-TB6560-V2.0
CW+
CW-
CLK+
EN-
EN+
CLK-
+24V
M-A
M-B
M-C
M-D
SW1
GND
SW2
DRIVER Z
DRIVER Y
DRIVER X
+24V - 2
+24V - 1
Sortie arret d'urgence
Pas en X
Direction X
Pas en Y
Pas en Z
Pas en A
Direction Y
Direction Z
Direction A
Limites X
Limites Y
Limites Z
Entree A/U
Marche broche
Entree palpeur
Arrosage
Activation (Enable)
CDP
L-OUT
N-OUT
L-IN
N-IN
+12V
+12V FAN
ARRO1
ARRO2
AC/DC 220Vac / 12Vdc
FAN
CDP IN
Palpeur
xxx
+5V
ARRO24
