wekospace/weko/(commit log)

2015-03-04 CNC: import des dxf en version 8.2
    [weko_cnc.dxf]
2015-03-04 CNC: mise à jour des dxf en version 8.3
    [weko_cnc.dxf]
2015-03-04 CNC: mise à jour des dxf en version 8.4
    [weko_cnc.dxf]
2015-03-04 CNC: mise à jour des dxf en version 8.5
    [weko_cnc.dxf]
2015-03-04 CNC: mise à jour des dxf en version 8.6
    [weko_cnc.dxf]
2015-03-04 CNC: mise à jour des dxf en version 8.7
    [weko_cnc.dxf]
2015-03-04 CNC: mise à jour des dxf en version 8.8
    [weko_cnc.dxf]
2015-03-04 CNC: Import de la nomenclature
    [Nomenclature.xls]
2015-03-04 CNC: Mise à jour de la nomenclature
    [Nomenclature.xls]
2015-03-04 Ajout du cablage
    [cablage.ods]
2015-03-05 Ajout de documentation concernant les paliers et les moteurs
2015-03-05 Ajout du support d'aspiration
    [support_aspirateur.dxf, support_aspirateur_verso.dxf]
2015-03-05 Aspiration: ajout du support des poils
    [support_poils.dxf]
2015-03-06 Aspiration: ajout d'une plaque de polycarbonate
    Ajout d'un socle pour accueillir les poils et les aimants
    [support_aimants.dxf, support_aspirateur.dxf, support_poils.dxf]
2015-04-27 Ajout du fichier 3D
    [cnc.fcstd]
2015-04-27 Ajout de plans individualisés de pièces (2D)
    [butee_switchs_Y.dxf, curseurs.dxf, divers.dxf, equerre_montant.dxf, facade_ar.dxf, facade_av.dxf, montant.dxf, plaque_Z_fixe.dxf]
2015-04-27 Ajout de plans utilisés pour l'usinage
    [Montant_avec_moteur_1-2.dxf, Montant_avec_moteur_2-2.dxf, Z_reprise_percage.dxf, curseur_X.dxf, curseur_Y.dxf, curseur_percage.dxf, profilé_X_percages.dxf, support_palierXY.dxf]
2015-10-14 Ajout du schéma électronique
    [cablage.ods, weko.sch]
