wekospace/weko/usinage/Montant_avec_moteur_2-2.dxf

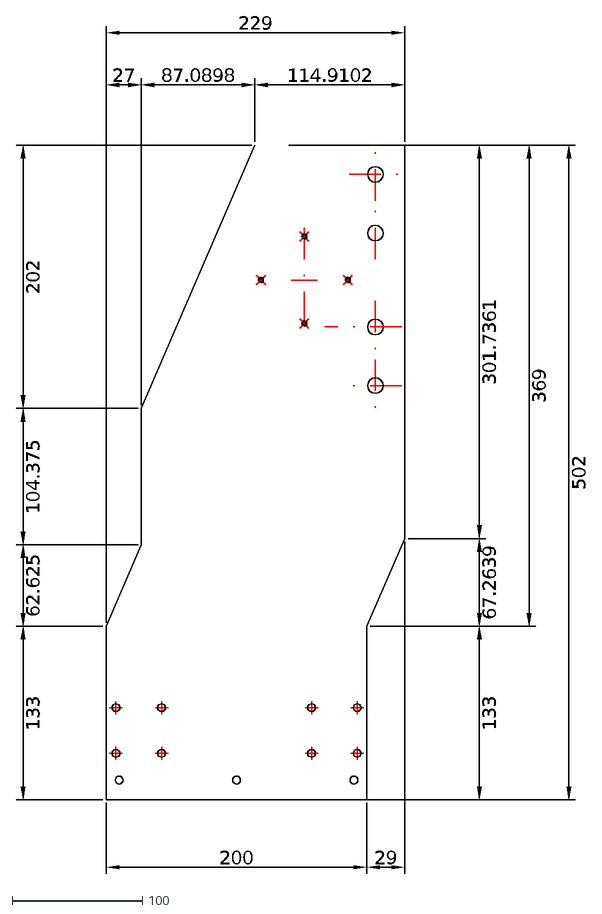
[picture p1: CAD file, 2015-04-27]
usinage/Montant_avec_moteur_2-2.dxf
133
67.2639
301.7361
502
62.625
104.375
202
114.9102
87.0898
200
29
27
229
369
